renbotics/Servo-Shield/(commit log)

2012-06-03 Arduino Mega fixes and updated for Arduino IDE 1.0
2012-06-03 Revert "Arduino Mega fixes and updated for Arduino IDE 1.0"
    This reverts commit 698a35c7337ddaa9ccf6768fd3778373a103dd09.
